Thoric16/Flight-controller/assets/schematic.png

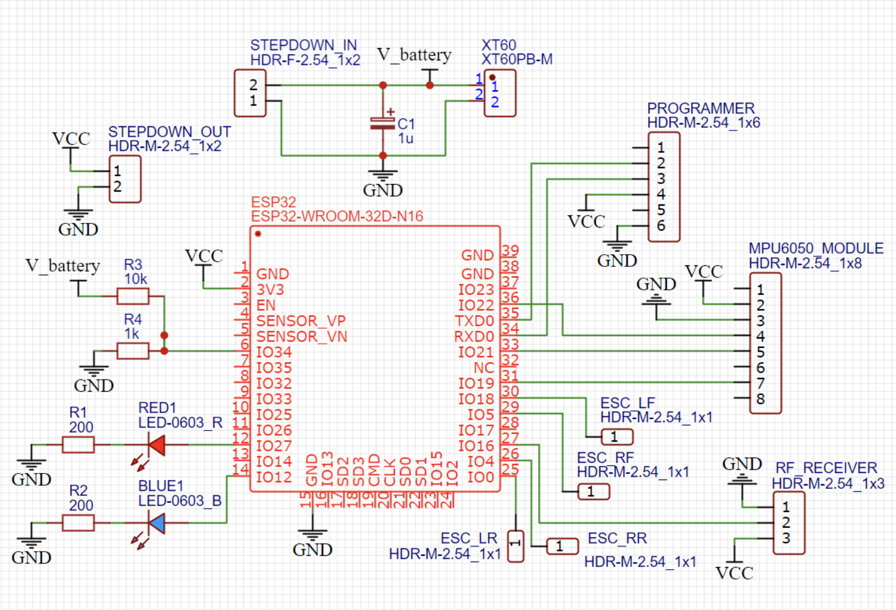
assets/schematic.png
